mikef5410/USB_SPII2CK/Mechanical/Case-Body.stl

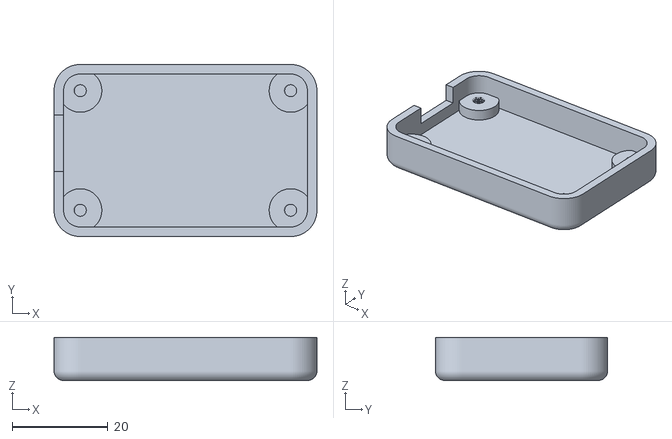
[picture p1: CAD file, 2024-10-08]
Mechanical/Case-Body.stl
55.0 x 36.0 x 9.00
