mikef5410/USB_SPII2CK/Mechanical/USB_SPII2CK_Board.FCStd

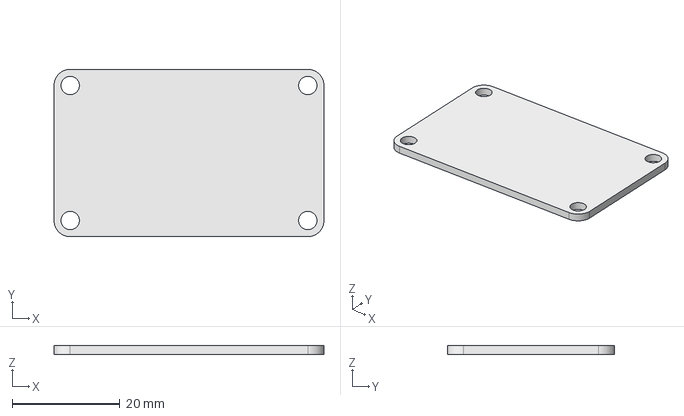
[picture p2: CAD file, 2024-07-22]
Mechanical/USB_SPII2CK_Board.FCStd
50.0 x 31.0 x 1.60 mm
