mikef5410/USB_SPII2CK/plots/USB_SPII2CK__Assembly.pdf

1 | 2 | 3 | 4 | 5 | 6

A

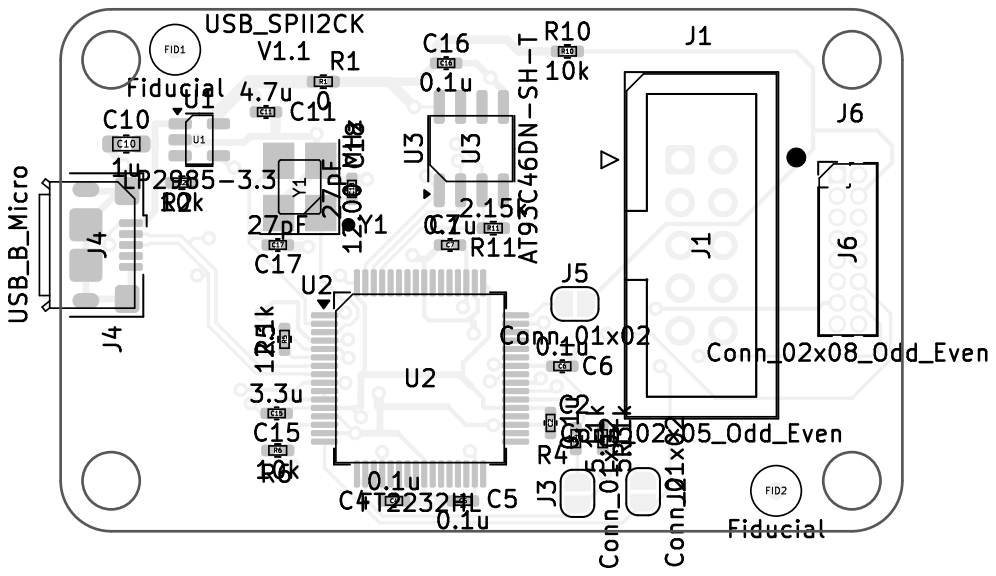
[picture p3: page 1]

1 | 2 | 3 | 4 | 5 | 6

A

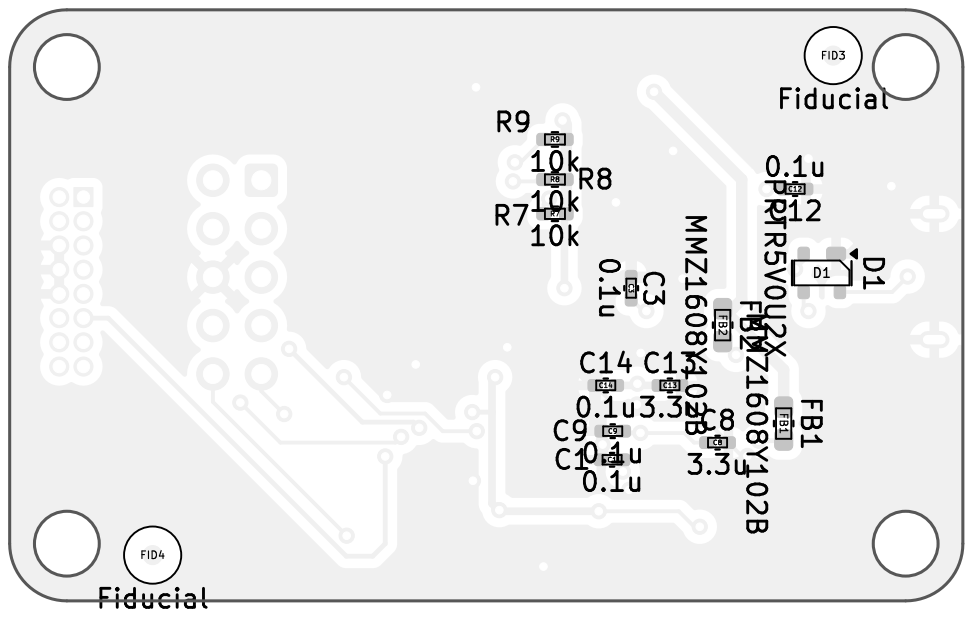
[picture p4: page 2]

Id: 1/1 Title: File: USB_SPII2CK.kicad_pcb Sheet:
