mikef5410/USB_SPII2CK/plots/schematic.pdf

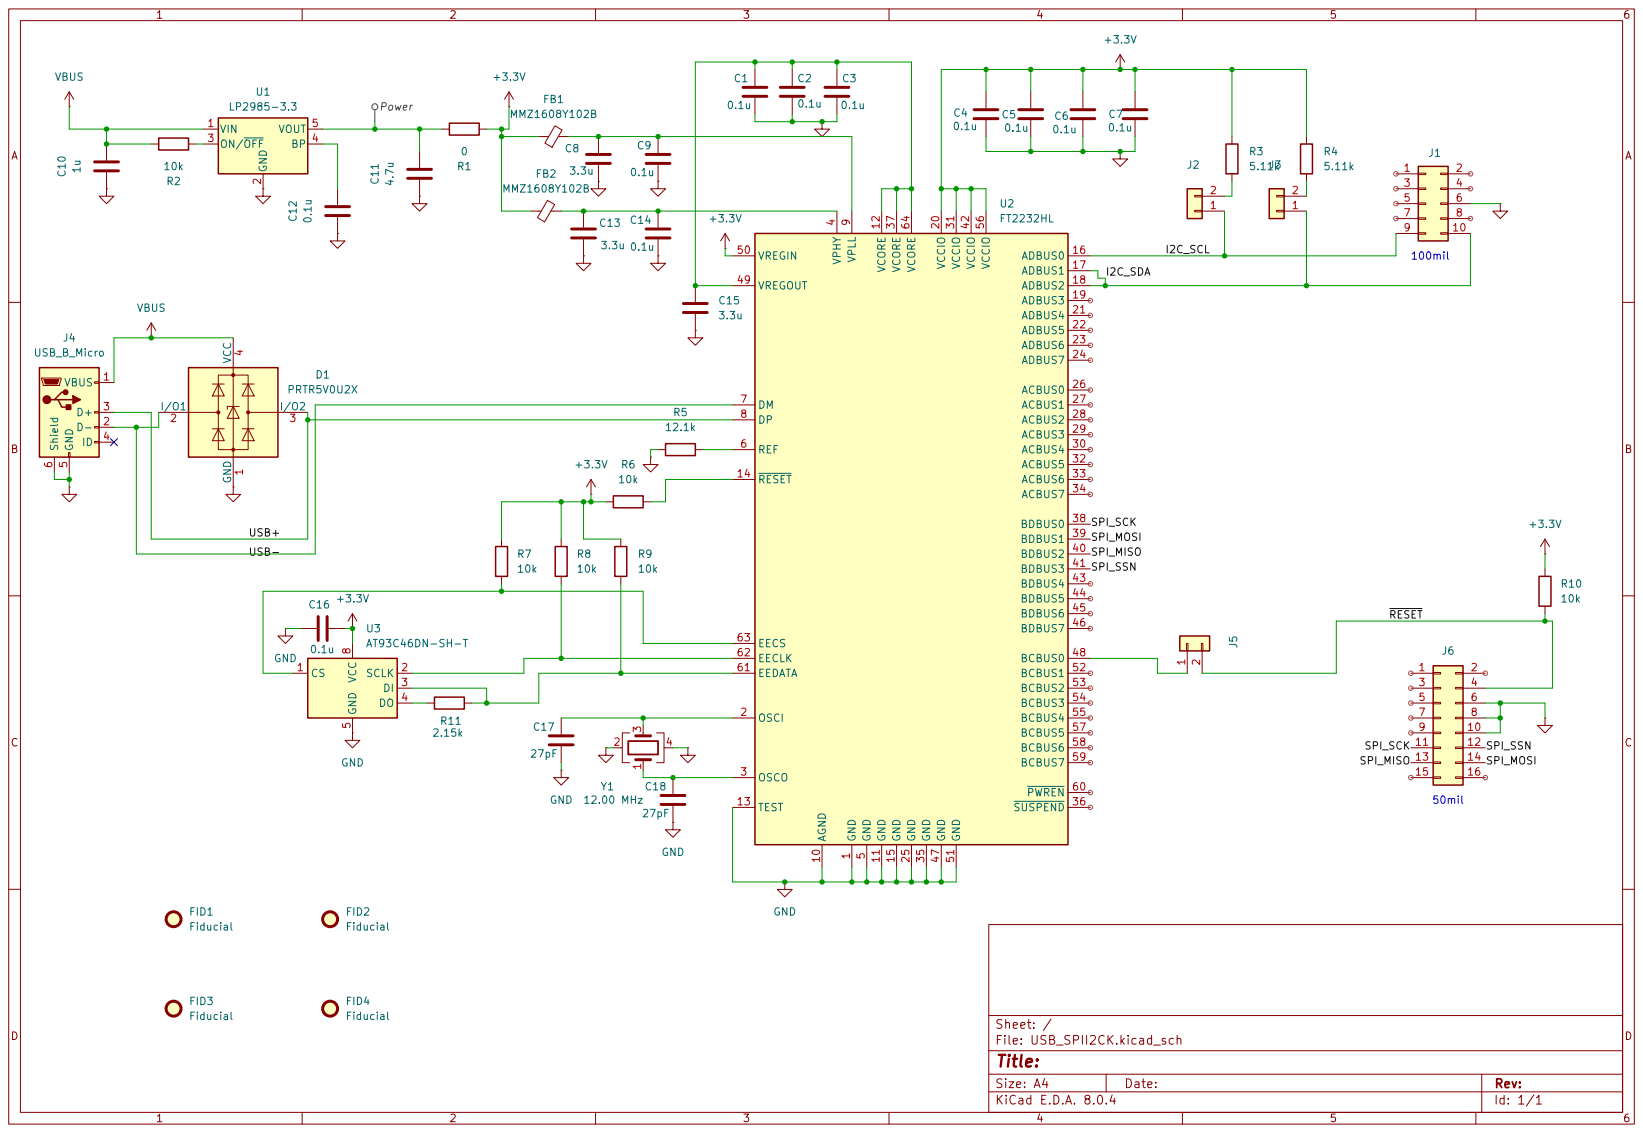
[picture p5: page 1]
