mikef5410/USB_SPII2CK/USB_SPII2CK.kicad_pcb

## KiCad design USB_SPII2CK.kicad_pcb (2024-10-08)

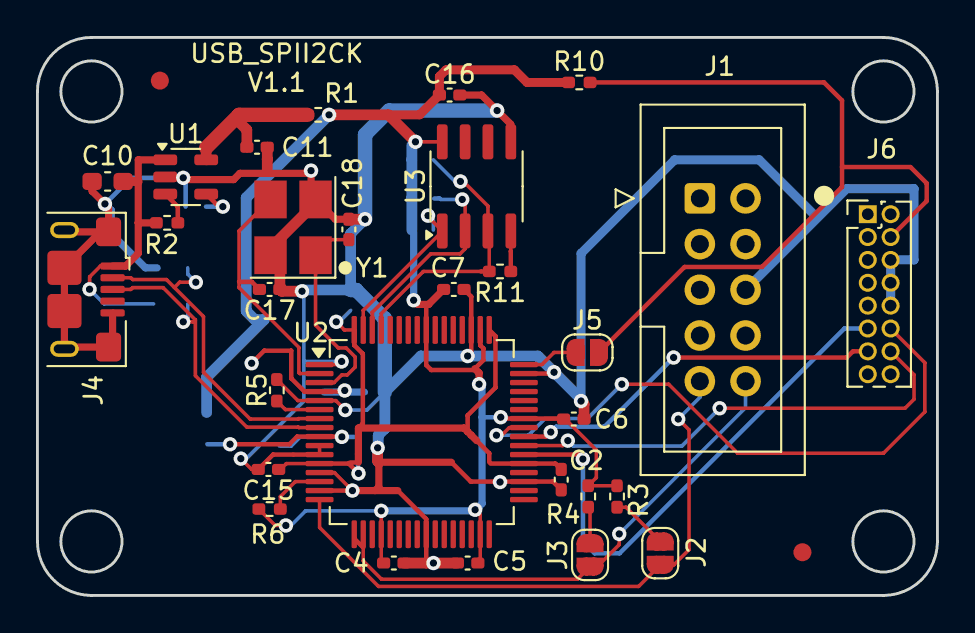
[picture p6: board USB_SPII2CK.kicad_pcb from above]

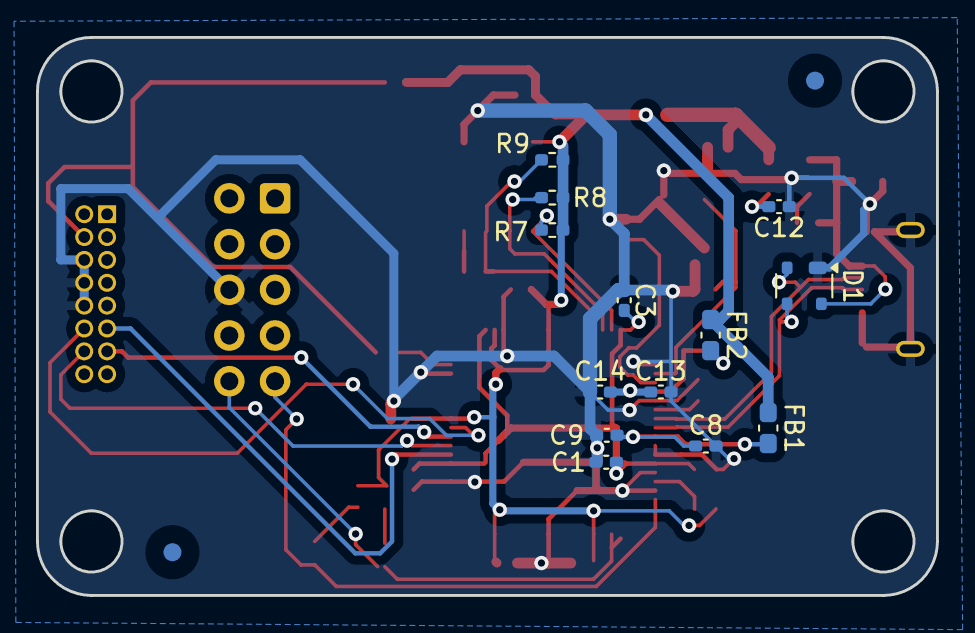
[picture p7: board USB_SPII2CK.kicad_pcb from below]

Board: 2 copper layers, 50.0 x 31.0 mm, 46 parts (15 on the bottom side), 29 nets.

Parts:
C1, C2, C3, C4, C5, C6, C7, C9, C12, C14, C16: 0.1u; C_0402_1005Metric_Pad0.74x0.62mm_HandSolder
C8, C13, C15: 3.3u; C_0402_1005Metric_Pad0.74x0.62mm_HandSolder
C10: 1u; C_0603_1608Metric_Pad1.08x0.95mm_HandSolder
C11: 4.7u; C_0402_1005Metric_Pad0.74x0.62mm_HandSolder
C17, C18: 27pF; C_0402_1005Metric_Pad0.74x0.62mm_HandSolder
D1: PRTR5V0U2X; SOT-143
FB1, FB2: MMZ1608Y102B; C_0603_1608Metric_Pad1.08x0.95mm_HandSolder
FID1, FID2, FID3, FID4: Fiducial; Fiducial_1mm_Mask3mm
J1: Conn_02x05_Odd_Even; IDC-Header_2x05_P2.54mm_Vertical
J2, J3, J5: Conn_01x02; SolderJumper-2_P1.3mm_Open_RoundedPad1.0x1.5mm
J4: USB_B_Micro; USB_Micro-B_Amphenol_10118193-0001LF_Horizontal
J6: Conn_02x08_Odd_Even; PinHeader_2x08_P1.27mm_Vertical
R1: 0; R_0402_1005Metric_Pad0.72x0.64mm_HandSolder
R2, R6, R7, R8, R9, R10: 10k; R_0402_1005Metric_Pad0.72x0.64mm_HandSolder
R3, R4: 5.11k; R_0402_1005Metric_Pad0.72x0.64mm_HandSolder
R5: 12.1k; R_0402_1005Metric_Pad0.72x0.64mm_HandSolder
R11: 2.15k; R_0402_1005Metric_Pad0.72x0.64mm_HandSolder
U1: LP2985-3.3; SOT-23-5
U2: FT2232HL; LQFP-64_10x10mm_P0.5mm
U3: AT93C46DN-SH-T; SOIC-8_3.9x4.9mm_P1.27mm
Y1: 12.00 MHz; Crystal_SMD_SeikoEpson_FA238V-4Pin_3.2x2.5mm_HandSoldering

Connections:
+3.3V: C4.2, C5.2, C6.2, C7.2, C16.1, FB1.1, FB2.1, R1.2, R3.2, R4.2, R6.1, R7.2, R8.2, R9.2, R10.1, U2.20 (VCCIO), U2.31 (VCCIO), U2.42 (VCCIO), U2.50 (VREGIN), U2.56 (VCCIO), U3.8 (VCC)
/I2C_SCL: J1.9, J2.1, U2.16 (ADBUS0)
/I2C_SDA: J1.10, J3.1, U2.17 (ADBUS1), U2.18 (ADBUS2)
/SPI_MISO: J6.13, U2.40 (BDBUS2)
/SPI_MOSI: J6.14, U2.39 (BDBUS1)
/SPI_SCK: J6.11, U2.38 (BDBUS0)
/SPI_SSN: J6.12, U2.41 (BDBUS3)
/USB+: D1.3 (I/O2), J4.3 (D+), U2.8 (DP)
/USB-: D1.2 (I/O1), J4.2 (D-), U2.7 (DM)
/~RESET: J5.2, J6.4, R10.2
GND: C1.1, C2.1, C3.1, C4.1, C5.1, C6.1, C7.1, C8.2, C9.1, C10.1, C11.1, C12.1, C13.2, C14.1, C15.2, C16.2, C17.1, C18.1, D1.1 (GND), J1.6, J4.5 (GND), J4.6 (Shield), J6.6, J6.8, J6.10, R5.1, U1.2 (GND), U2.1 (GND), U2.5 (GND), U2.10 (AGND), U2.11 (GND), U2.13 (TEST), U2.15 (GND), U2.25 (GND), U2.35 (GND), U2.47 (GND), U2.51 (GND), U3.5 (GND), Y1.2, Y1.4
unnamed: J2.2, R3.1
unnamed: J3.2, R4.1
unnamed: J5.1, U2.48 (BCBUS0)
unnamed: C12.2, U1.4 (BP)
unnamed: R2.2, U1.3 (ON/~OFF)
unnamed: C11.2, R1.1, U1.5 (VOUT)
unnamed: R8.1, U2.62 (EECLK), U3.2 (SCLK)
unnamed: R7.1, U2.63 (EECS), U3.1 (CS)
unnamed: R9.1, R11.2, U2.61 (EEDATA), U3.3 (DI)
unnamed: C17.2, U2.2 (OSCI), Y1.3
unnamed: C18.2, U2.3 (OSCO), Y1.1
unnamed: R5.2, U2.6 (REF)
unnamed: C13.1, C14.2, FB2.2, U2.4 (VPHY)
unnamed: C8.1, C9.2, FB1.2, U2.9 (VPLL)
unnamed: C1.2, C2.2, C3.2, C15.1, U2.12 (VCORE), U2.37 (VCORE), U2.49 (VREGOUT), U2.64 (VCORE)
unnamed: R6.2, U2.14 (~RESET)
unnamed: R11.1, U3.4 (DO)
VBUS: C10.2, D1.4 (VCC), J4.1 (VBUS), R2.1, U1.1 (VIN)
