mikef5410/USB_SPII2CK/(commit log)

2024-08-05 Add mechanicals.
    [USB_SPII2CK.kicad_pcb, USB_SPII2CK_Board.FCStd]
2024-08-06 Add a simple bottom half-case.
2024-10-08 Update to V1.1 (move R10 out from under connector)
    [BOM-USB_SPII2CK.csv, Case-Body.stl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]
